shahramBarai/DSD-project/reports/images/photo_2022-05-12_16-21-07.jpg

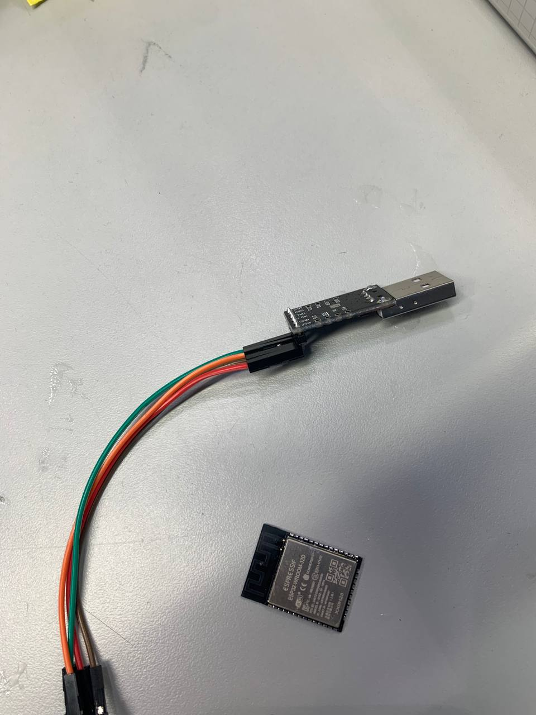
reports/images/photo_2022-05-12_16-21-07.jpg
