shahramBarai/DSD-project/schema/images/PCB_failed_v1.2.jpg

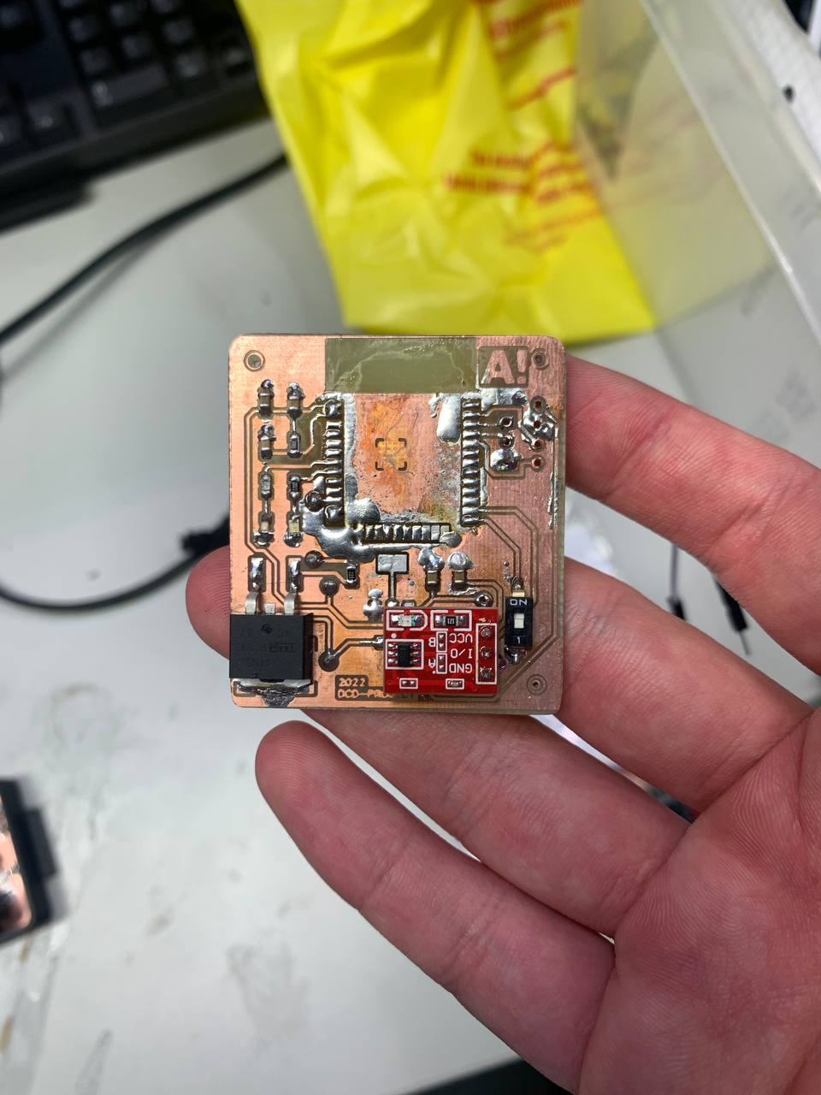
schema/images/PCB_failed_v1.2.jpg
