shahramBarai/DSD-project/schema/images/Top_Leayer.pdf

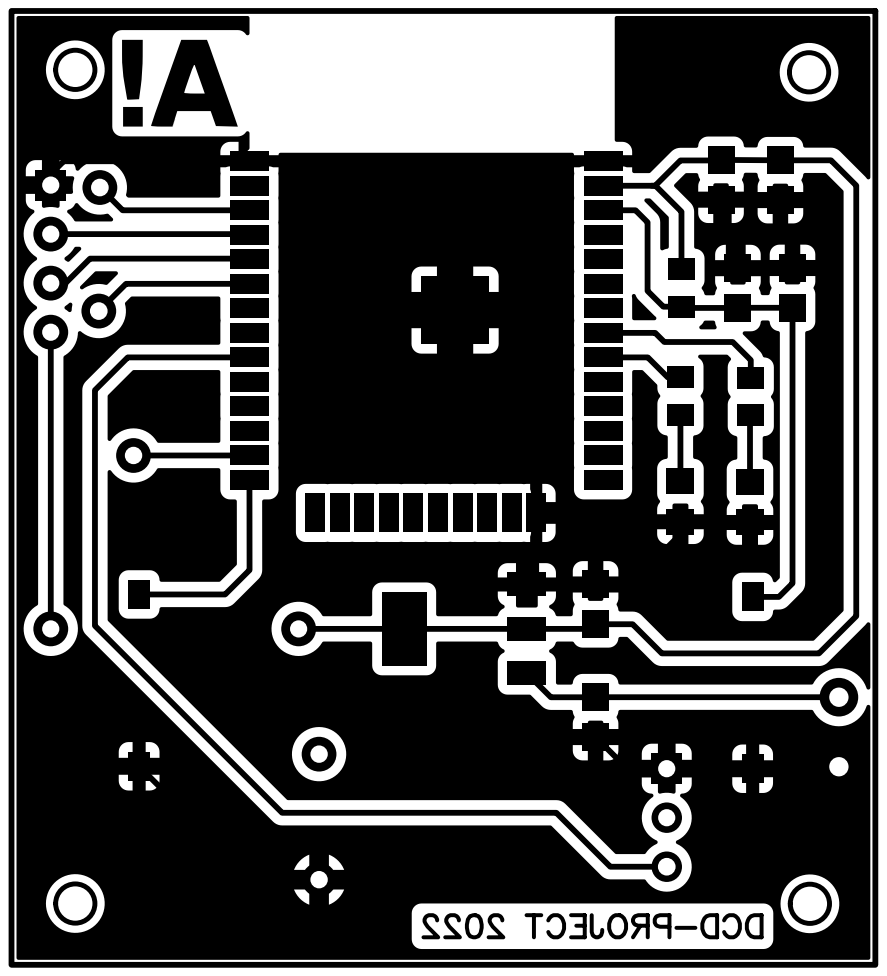
[picture p20: page 1]
